Jubakuba/Keycult-TKL-Kicad/Support All PCBS.kicad_sch

## KiCad design Support All PCBS.kicad_sch (2026-08-12)

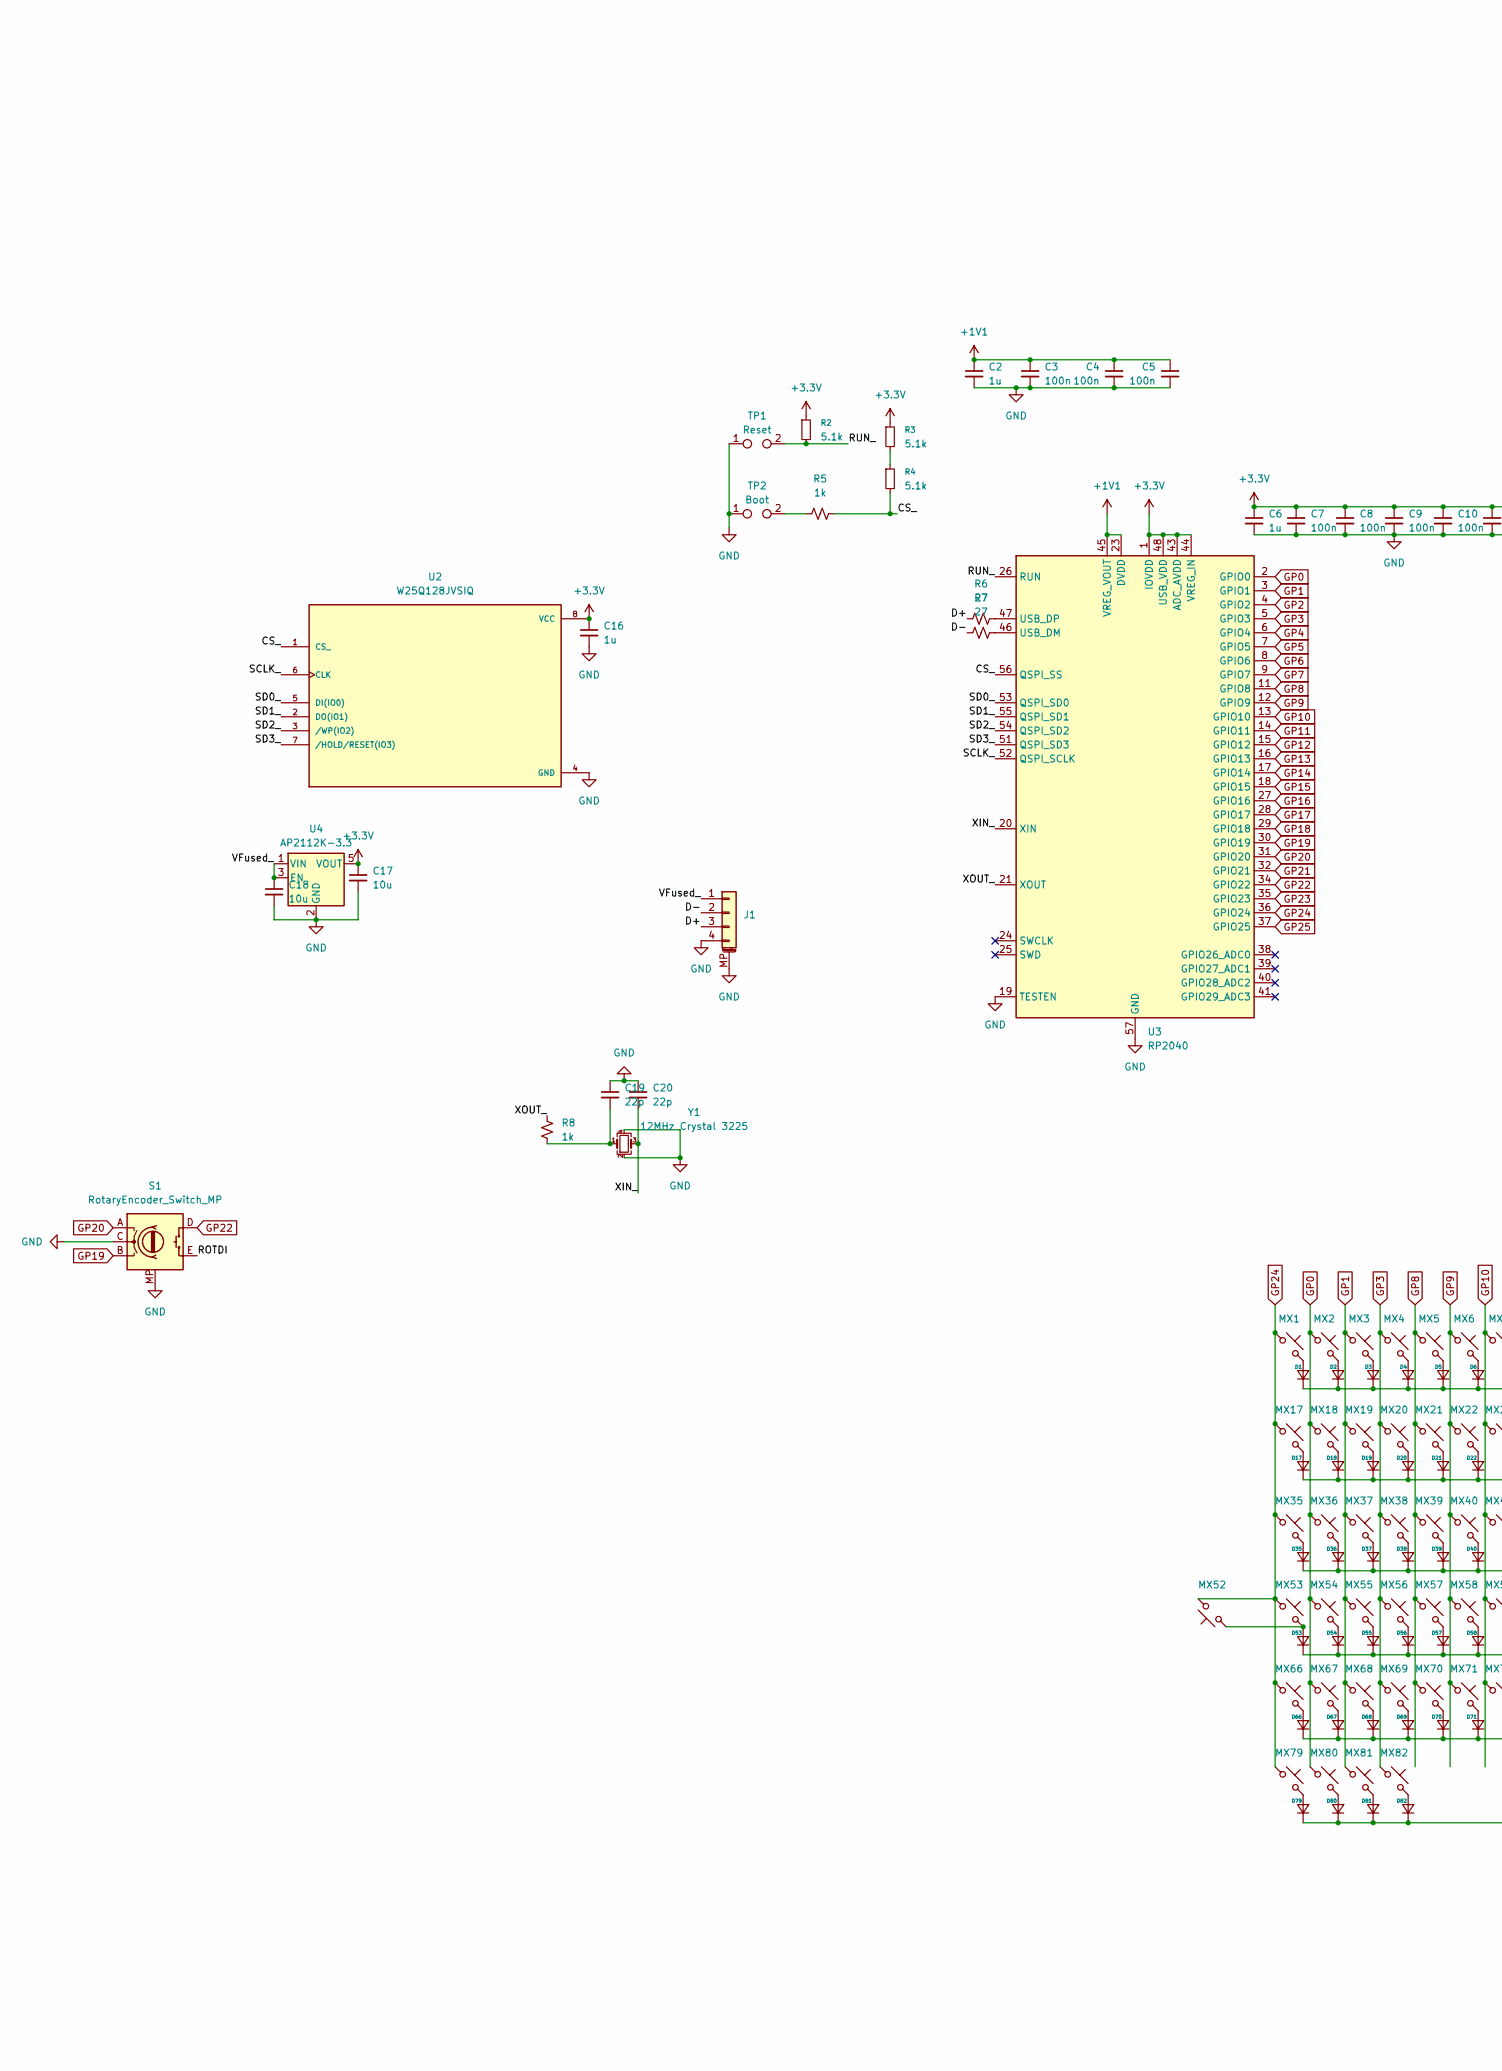
[picture p1: schematic Support All PCBS.kicad_sch, part in row 1, column 1]

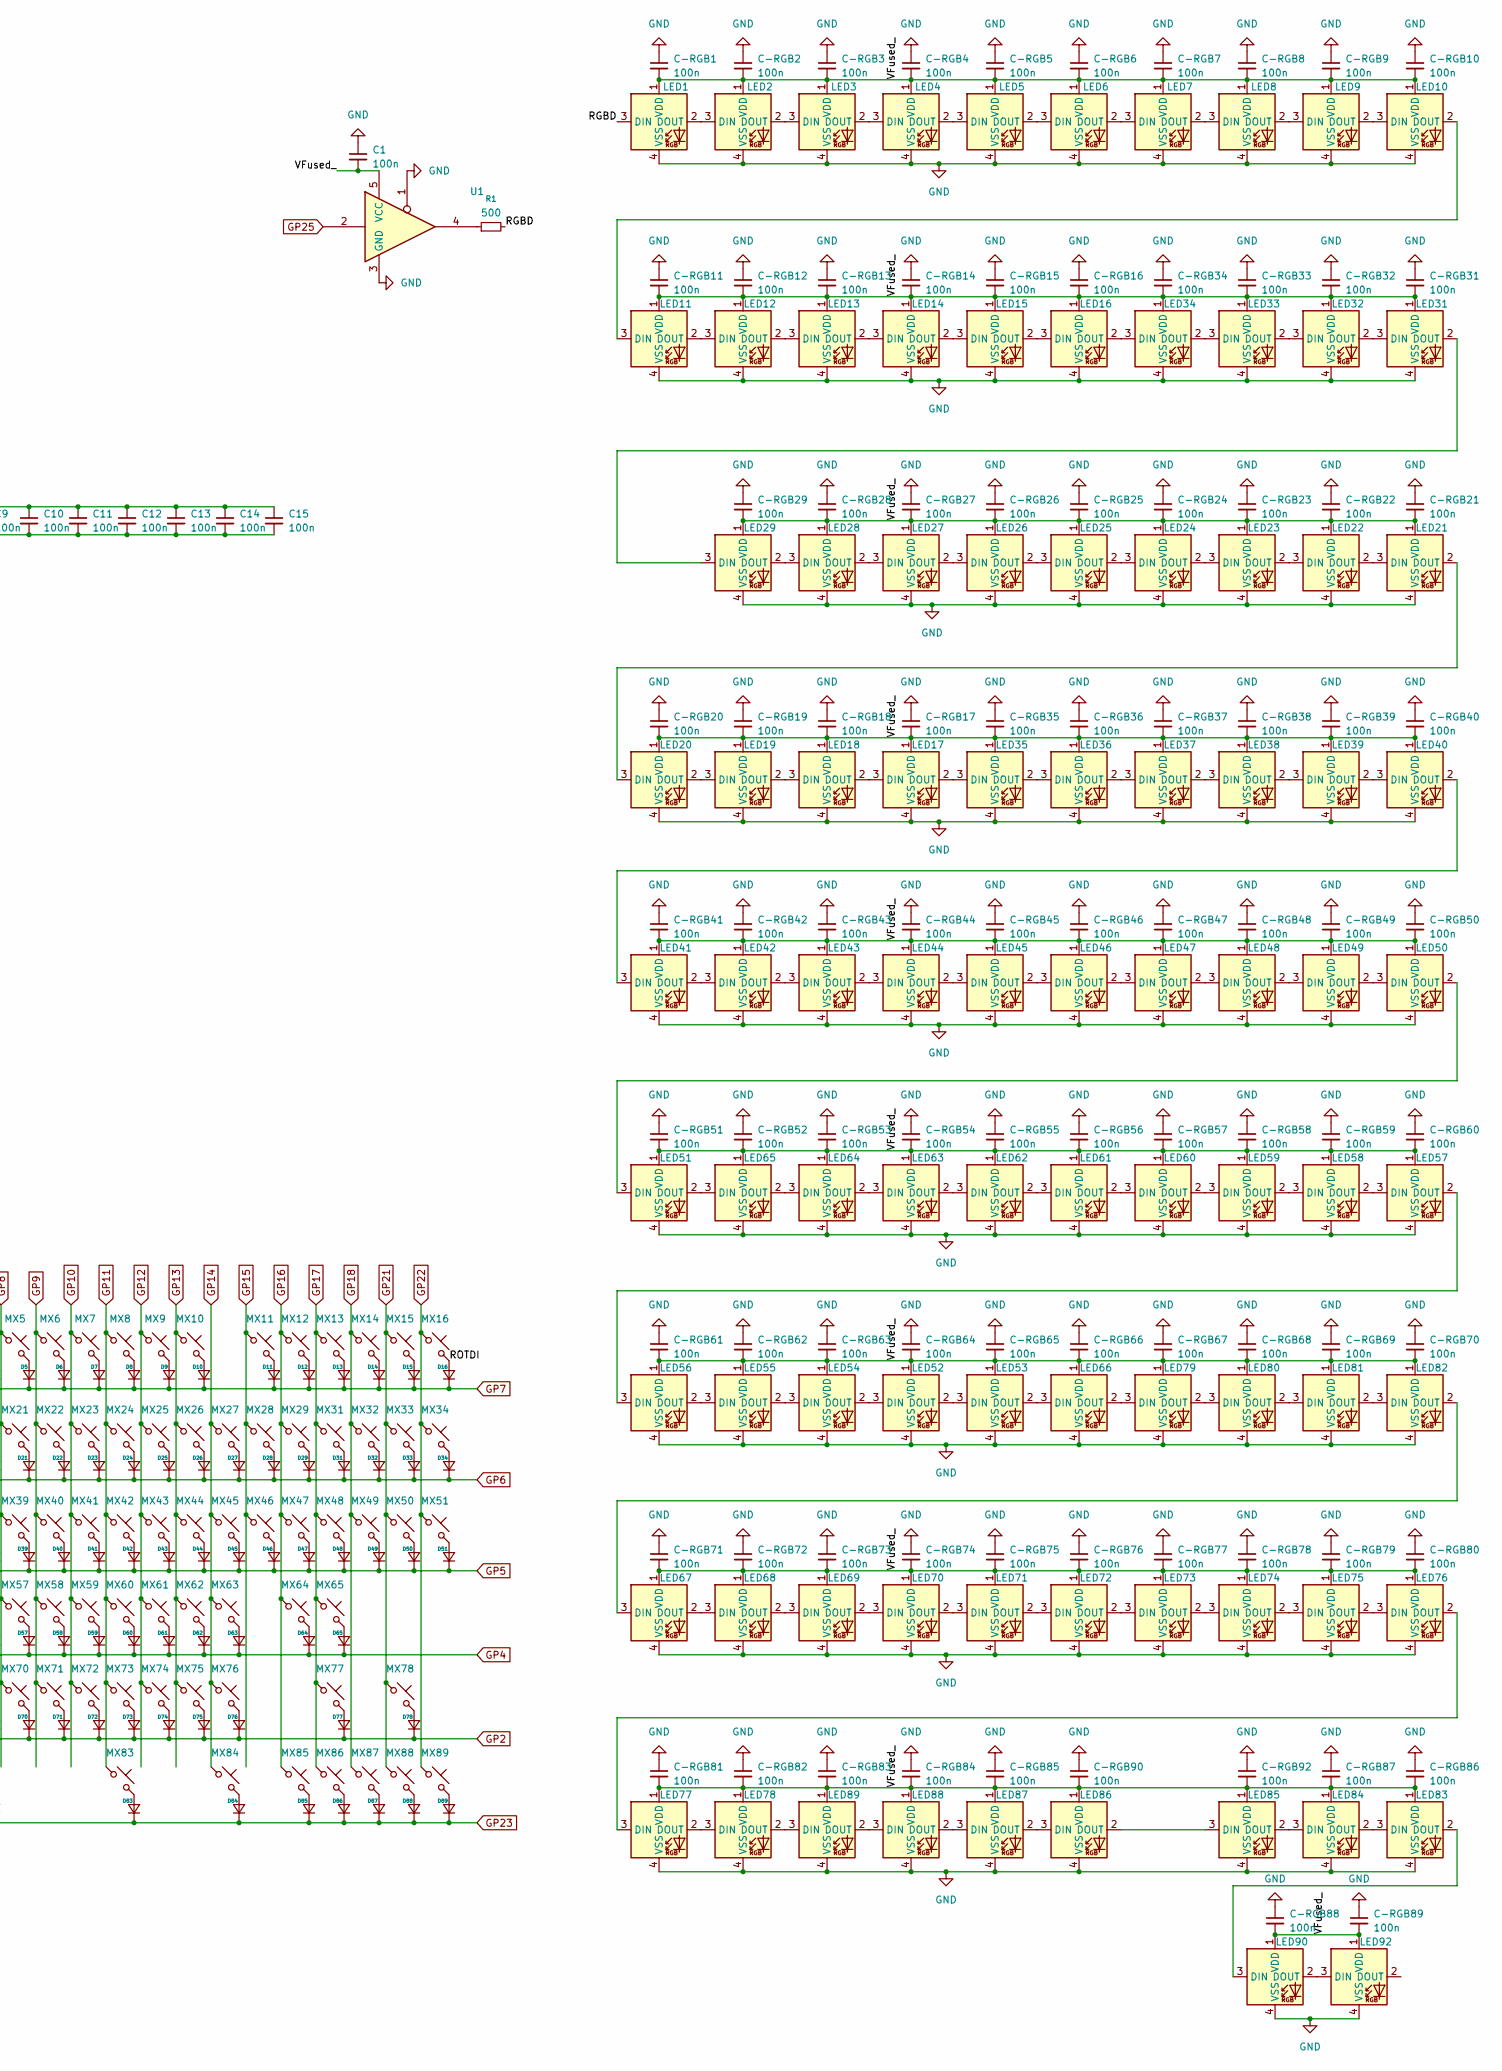
[picture p2: schematic Support All PCBS.kicad_sch, part in row 1, column 2]

Parts:
C1, C3, C4, C5, C7, C8, C9, C10, C11, C12, C13, C14, C15: 100n; C_0402_1005Metric; LCSC C1525
C2, C6, C16: 1u; C_0402_1005Metric; LCSC C52923
C17, C18: 10u; C_0402_1005Metric; LCSC C315248
C19, C20: 22p; C_0402_1005Metric; LCSC C190090
C-RGB1, C-RGB2, C-RGB3, C-RGB4, C-RGB5, C-RGB6, C-RGB7, C-RGB8, C-RGB9, C-RGB10, C-RGB11, C-RGB12, C-RGB13, C-RGB14, C-RGB15, C-RGB16, C-RGB17, C-RGB18, C-RGB19, C-RGB20, C-RGB21, C-RGB22, C-RGB23, C-RGB24, C-RGB25, C-RGB26, C-RGB27, C-RGB28, C-RGB29, C-RGB31, C-RGB32, C-RGB33, C-RGB34, C-RGB35, C-RGB36, C-RGB37, C-RGB38, C-RGB39, C-RGB40, C-RGB41, C-RGB42, C-RGB43, C-RGB44, C-RGB45, C-RGB46, C-RGB47, C-RGB48, C-RGB49, C-RGB50, C-RGB51, C-RGB52, C-RGB53, C-RGB54, C-RGB55, C-RGB56, C-RGB57, C-RGB58, C-RGB59, C-RGB60, C-RGB61, C-RGB62, C-RGB63, C-RGB64, C-RGB65, C-RGB66, C-RGB67, C-RGB68, C-RGB69, C-RGB70, C-RGB71, C-RGB72, C-RGB73, C-RGB74, C-RGB75, C-RGB76, C-RGB77, C-RGB78, C-RGB79, C-RGB80, C-RGB81, C-RGB82, C-RGB83, C-RGB84, C-RGB85, C-RGB86, C-RGB87, C-RGB88, C-RGB89, C-RGB90, C-RGB92: 100n; C_0402_1005Metric; LCSC C1525
D1, D2, D3, D4, D5, D6, D7, D8, D9, D10, D11, D12, D13, D14, D15, D16, D17, D18, D19, D20, D21, D22, D23, D24, D25, D26, D27, D28, D29, D31, D32, D33, D34, D35, D36, D37, D38, D39, D40, D41, D42, D43, D44, D45, D46, D47, D48, D49, D50, D51, D53, D54, D55, D56, D57, D58, D59, D60, D61, D62, D63, D64, D65, D66, D67, D68, D69, D70, D71, D72, D73, D74, D75, D76, D77, D78, D79, D80, D81, D82, D83, D84, D85, D86, D87, D88, D89: 1N4148W; D_SOD-123
J1: JST - 1.00mm 4 Pin; JST_SH_SM04B-SRSS-TB_1x04-1MP_P1.00mm_Horizontal; LCSC C160404
LED1, LED2, LED3, LED4, LED5, LED6, LED7, LED8, LED9, LED10, LED11, LED12, LED13, LED14, LED15, LED16, LED35, LED36, LED37, LED38, LED39, LED40, LED41, LED42, LED43, LED44, LED45, LED46, LED47, LED48, LED49, LED50, LED51, LED66, LED67, LED68, LED69, LED70, LED71, LED72, LED73, LED74, LED75, LED76, LED77, LED78, LED79, LED80, LED81, LED82: MX_SK6812MINI-E; LED_MX_6028R-ROT; LCSC C5149201
LED17, LED18, LED19, LED20, LED21, LED22, LED23, LED24, LED25, LED26, LED27, LED28, LED29, LED31, LED32, LED33, LED34, LED52, LED53, LED54, LED55, LED56, LED57, LED58, LED59, LED60, LED61, LED62, LED63, LED64, LED65, LED83, LED84, LED85, LED86, LED87, LED88, LED89, LED90, LED92: MX_SK6812MINI-E; LED_MX_6028R; LCSC C5149201
MX1, MX2, MX3, MX4, MX5, MX6, MX7, MX8, MX9, MX10, MX11, MX12, MX13, MX14, MX15, MX17, MX18, MX19, MX20, MX21, MX22, MX23, MX24, MX25, MX26, MX27, MX28, MX29, MX31, MX32, MX33, MX34, MX36, MX37, MX38, MX39, MX40, MX41, MX42, MX43, MX44, MX45, MX46, MX47, MX48, MX49, MX50, MX51, MX53, MX54, MX55, MX56, MX57, MX58, MX59, MX60, MX61, MX62, MX63, MX64, MX65, MX66, MX67, MX68, MX69, MX70, MX71, MX72, MX73, MX74, MX75, MX76, MX77, MX78, MX79, MX80, MX81, MX82, MX83, MX84, MX85, MX86, MX87, MX88, MX89: SW_MX_HS_CPG151101S11_1u; LCSC C49352235
MX16: SW_MX_HotSwap_THT; LCSC C49352235
MX35: SW_MX_HS_CPG151101S11_1.5u; LCSC C49352235
MX52: SW_MX_HS_CPG151101S11_1.75u_STP_1.25; LCSC C49352235
R1: 500; R_0402_1005Metric; LCSC C25117
R2, R3, R4: 5.1k; R_0402_1005Metric; LCSC C25905
R5, R8: 1k; R_0402_1005Metric; LCSC C106235
R6, R7: 27; R_0402_1005Metric; LCSC C22369246
S1: RotaryEncoder_Switch_MP; XDCR_EC11J1520402
TP1: Reset; R_0805_2012Metric
TP2: Boot; R_0805_2012Metric
U1: 74AHCT1G125; SOT-23-5; LCSC C7484
U2: W25Q128JVSIQ; SOIC-8_5.3x5.3mm_P1.27mm; PARTREV I; LCSC C97521
U3: RP2040; QFN-56-1EP_7x7mm_P0.4mm_EP3.2x3.2mm_ThermalVias; LCSC C2040
U4: AP2112K-3.3; SOT-23-5; LCSC C51118
Y1: 12MHz Crystal 3225; Crystal_SMD_3225-4Pin_3.2x2.5mm; LCSC C9002

Connections:
+1V1: C2.1, C3.1, C4.1, C5.1, U3.23 (DVDD), U3.45 (VREG_VOUT), U3.50 (DVDD)
+3.3V: C6.1, C7.1, C8.1, C9.1, C10.1, C11.1, C12.1, C13.1, C14.1, C15.1, C16.1, C17.1, R2.1, R3.1, U2.8 (VCC), U3.1 (IOVDD), U3.10 (IOVDD), U3.22 (IOVDD), U3.33 (IOVDD), U3.42 (IOVDD), U3.43 (ADC_AVDD), U3.44 (VREG_IN), U3.48 (USB_VDD), U3.49 (IOVDD), U4.5 (VOUT)
CS_: R4.2, R5.2, U2.1 (CS_), U3.56 (QSPI_SS)
D+: J1.3, R6.2
D-: J1.2, R7.1
GND: C1.1, C2.2, C3.2, C4.2, C5.2, C6.2, C7.2, C8.2, C9.2, C10.2, C11.2, C12.2, C13.2, C14.2, C15.2, C16.2, C17.2, C18.2, C19.1, C20.1, C-RGB1.1, C-RGB2.1, C-RGB3.1, C-RGB4.1, C-RGB5.1, C-RGB6.1, C-RGB7.1, C-RGB8.1, C-RGB9.1, C-RGB10.1, C-RGB11.1, C-RGB12.1, C-RGB13.1, C-RGB14.1, C-RGB15.1, C-RGB16.1, C-RGB17.1, C-RGB18.1, C-RGB19.1, C-RGB20.1, C-RGB21.1, C-RGB22.1, C-RGB23.1, C-RGB24.1, C-RGB25.1, C-RGB26.1, C-RGB27.1, C-RGB28.1, C-RGB29.1, C-RGB31.1, C-RGB32.1, C-RGB33.1, C-RGB34.1, C-RGB35.1, C-RGB36.1, C-RGB37.1, C-RGB38.1, C-RGB39.1, C-RGB40.1, C-RGB41.1, C-RGB42.1, C-RGB43.1, C-RGB44.1, C-RGB45.1, C-RGB46.1, C-RGB47.1, C-RGB48.1, C-RGB49.1, C-RGB50.1, C-RGB51.1, C-RGB52.1, C-RGB53.1, C-RGB54.1, C-RGB55.1, C-RGB56.1, C-RGB57.1, C-RGB58.1, C-RGB59.1, C-RGB60.1, C-RGB61.1, C-RGB62.1, C-RGB63.1, C-RGB64.1, C-RGB65.1, C-RGB66.1, C-RGB67.1, C-RGB68.1, C-RGB69.1, C-RGB70.1, C-RGB71.1, C-RGB72.1, C-RGB73.1, C-RGB74.1, C-RGB75.1, C-RGB76.1, C-RGB77.1, C-RGB78.1, C-RGB79.1, C-RGB80.1, C-RGB81.1, C-RGB82.1, C-RGB83.1, C-RGB84.1, C-RGB85.1, C-RGB86.1, C-RGB87.1, C-RGB88.1, C-RGB89.1, C-RGB90.1, C-RGB92.1, J1.4, J1.MP (MountPin), LED1.4 (VSS), LED2.4 (VSS), LED3.4 (VSS), LED4.4 (VSS), LED5.4 (VSS), LED6.4 (VSS), LED7.4 (VSS), LED8.4 (VSS), LED9.4 (VSS), LED10.4 (VSS), LED11.4 (VSS), LED12.4 (VSS), LED13.4 (VSS), LED14.4 (VSS), LED15.4 (VSS), LED16.4 (VSS), LED17.4 (VSS), LED18.4 (VSS), LED19.4 (VSS), LED20.4 (VSS), LED21.4 (VSS), LED22.4 (VSS), LED23.4 (VSS), LED24.4 (VSS), LED25.4 (VSS), LED26.4 (VSS), LED27.4 (VSS), LED28.4 (VSS), LED29.4 (VSS), LED31.4 (VSS), LED32.4 (VSS), LED33.4 (VSS), LED34.4 (VSS), LED35.4 (VSS), LED36.4 (VSS), LED37.4 (VSS), LED38.4 (VSS), LED39.4 (VSS), LED40.4 (VSS), LED41.4 (VSS), LED42.4 (VSS), LED43.4 (VSS), LED44.4 (VSS), LED45.4 (VSS), LED46.4 (VSS), LED47.4 (VSS), LED48.4 (VSS), LED49.4 (VSS), LED50.4 (VSS), LED51.4 (VSS), LED52.4 (VSS), LED53.4 (VSS), LED54.4 (VSS), LED55.4 (VSS), LED56.4 (VSS), LED57.4 (VSS), LED58.4 (VSS), LED59.4 (VSS), LED60.4 (VSS), LED61.4 (VSS), LED62.4 (VSS), LED63.4 (VSS), LED64.4 (VSS), LED65.4 (VSS), LED66.4 (VSS), LED67.4 (VSS), LED68.4 (VSS), LED69.4 (VSS), LED70.4 (VSS), LED71.4 (VSS), LED72.4 (VSS), LED73.4 (VSS), LED74.4 (VSS), LED75.4 (VSS), LED76.4 (VSS), LED77.4 (VSS), LED78.4 (VSS), LED79.4 (VSS), LED80.4 (VSS), LED81.4 (VSS), LED82.4 (VSS), LED83.4 (VSS), LED84.4 (VSS), LED85.4 (VSS), LED86.4 (VSS), LED87.4 (VSS), LED88.4 (VSS), LED89.4 (VSS), LED90.4 (VSS), LED92.4 (VSS), S1.C, S1.MP, TP1.1, TP2.1, U1.1, U1.3 (GND), U2.4 (GND), U3.19 (TESTEN), U3.57 (GND), U4.2 (GND), Y1.2, Y1.4
GP0: MX2.1, MX18.1, MX36.1, MX54.1, MX67.1, MX80.1, U3.2 (GPIO0)
GP1: MX3.1, MX19.1, MX37.1, MX55.1, MX68.1, MX81.1, U3.3 (GPIO1)
GP2: D66.1 (K), D67.1 (K), D68.1 (K), D69.1 (K), D70.1 (K), D71.1 (K), D72.1 (K), D73.1 (K), D74.1 (K), D75.1 (K), D76.1 (K), D77.1 (K), D78.1 (K), U3.4 (GPIO2)
GP3: MX4.1, MX20.1, MX38.1, MX56.1, MX69.1, MX82.1, U3.5 (GPIO3)
GP4: D53.1 (K), D54.1 (K), D55.1 (K), D56.1 (K), D57.1 (K), D58.1 (K), D59.1 (K), D60.1 (K), D61.1 (K), D62.1 (K), D63.1 (K), D64.1 (K), D65.1 (K), U3.6 (GPIO4)
GP5: D35.1 (K), D36.1 (K), D37.1 (K), D38.1 (K), D39.1 (K), D40.1 (K), D41.1 (K), D42.1 (K), D43.1 (K), D44.1 (K), D45.1 (K), D46.1 (K), D47.1 (K), D48.1 (K), D49.1 (K), D50.1 (K), D51.1 (K), U3.7 (GPIO5)
GP6: D17.1 (K), D18.1 (K), D19.1 (K), D20.1 (K), D21.1 (K), D22.1 (K), D23.1 (K), D24.1 (K), D25.1 (K), D26.1 (K), D27.1 (K), D28.1 (K), D29.1 (K), D31.1 (K), D32.1 (K), D33.1 (K), D34.1 (K), U3.8 (GPIO6)
GP7: D1.1 (K), D2.1 (K), D3.1 (K), D4.1 (K), D5.1 (K), D6.1 (K), D7.1 (K), D8.1 (K), D9.1 (K), D10.1 (K), D11.1 (K), D12.1 (K), D13.1 (K), D14.1 (K), D15.1 (K), D16.1 (K), U3.9 (GPIO7)
GP8: MX5.1, MX21.1, MX39.1, MX57.1, MX70.1, U3.11 (GPIO8)
GP9: MX6.1, MX22.1, MX40.1, MX58.1, MX71.1, U3.12 (GPIO9)
GP10: MX7.1, MX23.1, MX41.1, MX59.1, MX72.1, U3.13 (GPIO10)
GP11: MX8.1, MX24.1, MX42.1, MX60.1, MX73.1, MX83.1, U3.14 (GPIO11)
GP12: MX9.1, MX25.1, MX43.1, MX61.1, MX74.1, U3.15 (GPIO12)
GP13: MX10.1, MX26.1, MX44.1, MX62.1, MX75.1, U3.16 (GPIO13)
GP14: MX27.1, MX45.1, MX63.1, MX76.1, MX84.1, U3.17 (GPIO14)
GP15: MX11.1, MX28.1, MX46.1, U3.18 (GPIO15)
GP16: MX12.1, MX29.1, MX47.1, MX64.1, MX85.1, U3.27 (GPIO16)
GP17: MX13.1, MX31.1, MX48.1, MX65.1, MX77.1, MX86.1, U3.28 (GPIO17)
GP18: MX14.1, MX32.1, MX49.1, MX87.1, U3.29 (GPIO18)
GP19: S1.B, U3.30 (GPIO19)
GP20: S1.A, U3.31 (GPIO20)
GP21: MX15.1, MX33.1, MX50.1, MX78.1, MX88.1, U3.32 (GPIO21)
GP22: MX16.1, MX34.1, MX51.1, MX89.1, S1.D, U3.34 (GPIO22)
GP23: D79.1 (K), D80.1 (K), D81.1 (K), D82.1 (K), D83.1 (K), D84.1 (K), D85.1 (K), D86.1 (K), D87.1 (K), D88.1 (K), D89.1 (K), U3.35 (GPIO23)
GP24: MX1.1, MX17.1, MX35.1, MX52.2, MX53.1, MX66.1, MX79.1, U3.36 (GPIO24)
GP25: U1.2, U3.37 (GPIO25)
unnamed: C19.2, R8.1, Y1.1
unnamed: D1.2 (A), MX1.2
unnamed: D2.2 (A), MX2.2
unnamed: D3.2 (A), MX3.2
unnamed: D4.2 (A), MX4.2
unnamed: D5.2 (A), MX5.2
unnamed: D6.2 (A), MX6.2
unnamed: D7.2 (A), MX7.2
unnamed: D8.2 (A), MX8.2
unnamed: D9.2 (A), MX9.2
unnamed: D10.2 (A), MX10.2
unnamed: D11.2 (A), MX11.2
unnamed: D12.2 (A), MX12.2
unnamed: D13.2 (A), MX13.2
unnamed: D14.2 (A), MX14.2
unnamed: D15.2 (A), MX15.2
unnamed: D17.2 (A), MX17.2
unnamed: D18.2 (A), MX18.2
unnamed: D19.2 (A), MX19.2
unnamed: D20.2 (A), MX20.2
unnamed: D21.2 (A), MX21.2
unnamed: D22.2 (A), MX22.2
unnamed: D23.2 (A), MX23.2
unnamed: D24.2 (A), MX24.2
unnamed: D25.2 (A), MX25.2
unnamed: D26.2 (A), MX26.2
unnamed: D27.2 (A), MX27.2
unnamed: D28.2 (A), MX28.2
unnamed: D29.2 (A), MX29.2
unnamed: D31.2 (A), MX31.2
unnamed: D32.2 (A), MX32.2
unnamed: D33.2 (A), MX33.2
unnamed: D34.2 (A), MX34.2
unnamed: D35.2 (A), MX35.2
unnamed: D36.2 (A), MX36.2
unnamed: D37.2 (A), MX37.2
unnamed: D38.2 (A), MX38.2
unnamed: D39.2 (A), MX39.2
unnamed: D40.2 (A), MX40.2
unnamed: D41.2 (A), MX41.2
unnamed: D42.2 (A), MX42.2
unnamed: D43.2 (A), MX43.2
unnamed: D44.2 (A), MX44.2
unnamed: D45.2 (A), MX45.2
unnamed: D46.2 (A), MX46.2
unnamed: D47.2 (A), MX47.2
unnamed: D48.2 (A), MX48.2
unnamed: D49.2 (A), MX49.2
unnamed: D50.2 (A), MX50.2
unnamed: D51.2 (A), MX51.2
unnamed: D53.2 (A), MX52.1, MX53.2
unnamed: D54.2 (A), MX54.2
unnamed: D55.2 (A), MX55.2
unnamed: D56.2 (A), MX56.2
unnamed: D57.2 (A), MX57.2
unnamed: D58.2 (A), MX58.2
unnamed: D59.2 (A), MX59.2
unnamed: D60.2 (A), MX60.2
unnamed: D61.2 (A), MX61.2
unnamed: D62.2 (A), MX62.2
unnamed: D63.2 (A), MX63.2
unnamed: D64.2 (A), MX64.2
unnamed: D65.2 (A), MX65.2
unnamed: D66.2 (A), MX66.2
unnamed: D67.2 (A), MX67.2
unnamed: D68.2 (A), MX68.2
unnamed: D69.2 (A), MX69.2
unnamed: D70.2 (A), MX70.2
unnamed: D71.2 (A), MX71.2
unnamed: D72.2 (A), MX72.2
unnamed: D73.2 (A), MX73.2
unnamed: D74.2 (A), MX74.2
unnamed: D75.2 (A), MX75.2
unnamed: D76.2 (A), MX76.2
unnamed: D77.2 (A), MX77.2
unnamed: D78.2 (A), MX78.2
unnamed: D79.2 (A), MX79.2
unnamed: D80.2 (A), MX80.2
unnamed: D81.2 (A), MX81.2
unnamed: D82.2 (A), MX82.2
unnamed: D83.2 (A), MX83.2
unnamed: D84.2 (A), MX84.2
unnamed: D85.2 (A), MX85.2
unnamed: D86.2 (A), MX86.2
unnamed: D87.2 (A), MX87.2
unnamed: D88.2 (A), MX88.2
unnamed: D89.2 (A), MX89.2
unnamed: LED1.2 (DOUT), LED2.3 (DIN)
unnamed: LED2.2 (DOUT), LED3.3 (DIN)
unnamed: LED3.2 (DOUT), LED4.3 (DIN)
unnamed: LED4.2 (DOUT), LED5.3 (DIN)
unnamed: LED5.2 (DOUT), LED6.3 (DIN)
unnamed: LED6.2 (DOUT), LED7.3 (DIN)
unnamed: LED7.2 (DOUT), LED8.3 (DIN)
unnamed: LED8.2 (DOUT), LED9.3 (DIN)
unnamed: LED10.2 (DOUT), LED11.3 (DIN)
unnamed: LED9.2 (DOUT), LED10.3 (DIN)
unnamed: LED11.2 (DOUT), LED12.3 (DIN)
unnamed: LED12.2 (DOUT), LED13.3 (DIN)
unnamed: LED13.2 (DOUT), LED14.3 (DIN)
unnamed: LED14.2 (DOUT), LED15.3 (DIN)
unnamed: LED15.2 (DOUT), LED16.3 (DIN)
unnamed: LED16.2 (DOUT), LED34.3 (DIN)
unnamed: LED17.2 (DOUT), LED35.3 (DIN)
unnamed: LED17.3 (DIN), LED18.2 (DOUT)
unnamed: LED18.3 (DIN), LED19.2 (DOUT)
unnamed: LED19.3 (DIN), LED20.2 (DOUT)
unnamed: LED20.3 (DIN), LED21.2 (DOUT)
unnamed: LED21.3 (DIN), LED22.2 (DOUT)
unnamed: LED22.3 (DIN), LED23.2 (DOUT)
unnamed: LED23.3 (DIN), LED24.2 (DOUT)
unnamed: LED24.3 (DIN), LED25.2 (DOUT)
unnamed: LED25.3 (DIN), LED26.2 (DOUT)
unnamed: LED26.3 (DIN), LED27.2 (DOUT)
unnamed: LED27.3 (DIN), LED28.2 (DOUT)
unnamed: LED28.3 (DIN), LED29.2 (DOUT)
unnamed: LED29.3 (DIN), LED31.2 (DOUT)
unnamed: LED31.3 (DIN), LED32.2 (DOUT)
unnamed: LED32.3 (DIN), LED33.2 (DOUT)
unnamed: LED33.3 (DIN), LED34.2 (DOUT)
unnamed: LED35.2 (DOUT), LED36.3 (DIN)
unnamed: LED36.2 (DOUT), LED37.3 (DIN)
unnamed: LED37.2 (DOUT), LED38.3 (DIN)
unnamed: LED38.2 (DOUT), LED39.3 (DIN)
unnamed: LED39.2 (DOUT), LED40.3 (DIN)
unnamed: LED40.2 (DOUT), LED41.3 (DIN)
unnamed: LED41.2 (DOUT), LED42.3 (DIN)
unnamed: LED42.2 (DOUT), LED43.3 (DIN)
unnamed: LED43.2 (DOUT), LED44.3 (DIN)
unnamed: LED44.2 (DOUT), LED45.3 (DIN)
unnamed: LED45.2 (DOUT), LED46.3 (DIN)
unnamed: LED46.2 (DOUT), LED47.3 (DIN)
unnamed: LED47.2 (DOUT), LED48.3 (DIN)
unnamed: LED48.2 (DOUT), LED49.3 (DIN)
unnamed: LED49.2 (DOUT), LED50.3 (DIN)
unnamed: LED50.2 (DOUT), LED51.3 (DIN)
unnamed: LED51.2 (DOUT), LED65.3 (DIN)
unnamed: LED52.2 (DOUT), LED53.3 (DIN)
unnamed: LED52.3 (DIN), LED54.2 (DOUT)
unnamed: LED53.2 (DOUT), LED66.3 (DIN)
unnamed: LED54.3 (DIN), LED55.2 (DOUT)
unnamed: LED55.3 (DIN), LED56.2 (DOUT)
unnamed: LED56.3 (DIN), LED57.2 (DOUT)
unnamed: LED57.3 (DIN), LED58.2 (DOUT)
unnamed: LED58.3 (DIN), LED59.2 (DOUT)
unnamed: LED59.3 (DIN), LED60.2 (DOUT)
unnamed: LED60.3 (DIN), LED61.2 (DOUT)
unnamed: LED61.3 (DIN), LED62.2 (DOUT)
unnamed: LED62.3 (DIN), LED63.2 (DOUT)
unnamed: LED63.3 (DIN), LED64.2 (DOUT)
unnamed: LED64.3 (DIN), LED65.2 (DOUT)
unnamed: LED66.2 (DOUT), LED79.3 (DIN)
unnamed: LED67.2 (DOUT), LED68.3 (DIN)
unnamed: LED67.3 (DIN), LED82.2 (DOUT)
unnamed: LED68.2 (DOUT), LED69.3 (DIN)
unnamed: LED69.2 (DOUT), LED70.3 (DIN)
unnamed: LED70.2 (DOUT), LED71.3 (DIN)
unnamed: LED71.2 (DOUT), LED72.3 (DIN)
unnamed: LED72.2 (DOUT), LED73.3 (DIN)
unnamed: LED73.2 (DOUT), LED74.3 (DIN)
unnamed: LED74.2 (DOUT), LED75.3 (DIN)
unnamed: LED75.2 (DOUT), LED76.3 (DIN)
unnamed: LED76.2 (DOUT), LED77.3 (DIN)
unnamed: LED77.2 (DOUT), LED78.3 (DIN)
unnamed: LED78.2 (DOUT), LED89.3 (DIN)
unnamed: LED79.2 (DOUT), LED80.3 (DIN)
unnamed: LED80.2 (DOUT), LED81.3 (DIN)
unnamed: LED81.2 (DOUT), LED82.3 (DIN)
unnamed: LED83.2 (DOUT), LED90.3 (DIN)
unnamed: LED83.3 (DIN), LED84.2 (DOUT)
unnamed: LED84.3 (DIN), LED85.2 (DOUT)
unnamed: LED85.3 (DIN), LED86.2 (DOUT)
unnamed: LED86.3 (DIN), LED87.2 (DOUT)
unnamed: LED87.3 (DIN), LED88.2 (DOUT)
unnamed: LED88.3 (DIN), LED89.2 (DOUT)
unnamed: LED90.2 (DOUT), LED92.3 (DIN)
unnamed: R1.1, U1.4
unnamed: R3.2, R4.1
unnamed: R5.1, TP2.2
unnamed: R6.1, U3.47 (USB_DP)
unnamed: R7.2, U3.46 (USB_DM)
RGBD: LED1.3 (DIN), R1.2
ROTDI: D16.2 (A), MX16.2, S1.E
RUN_: R2.2, TP1.2, U3.26 (RUN)
SCLK_: U2.6 (CLK), U3.52 (QSPI_SCLK)
SD0_: U2.5 (DI(IO0)), U3.53 (QSPI_SD0)
SD1_: U2.2 (DO(IO1)), U3.55 (QSPI_SD1)
SD2_: U2.3 (/WP(IO2)), U3.54 (QSPI_SD2)
SD3_: U2.7 (/HOLD/RESET(IO3)), U3.51 (QSPI_SD3)
VFused_: C1.2, C18.1, C-RGB1.2, C-RGB2.2, C-RGB3.2, C-RGB4.2, C-RGB5.2, C-RGB6.2, C-RGB7.2, C-RGB8.2, C-RGB9.2, C-RGB10.2, C-RGB11.2, C-RGB12.2, C-RGB13.2, C-RGB14.2, C-RGB15.2, C-RGB16.2, C-RGB17.2, C-RGB18.2, C-RGB19.2, C-RGB20.2, C-RGB21.2, C-RGB22.2, C-RGB23.2, C-RGB24.2, C-RGB25.2, C-RGB26.2, C-RGB27.2, C-RGB28.2, C-RGB29.2, C-RGB31.2, C-RGB32.2, C-RGB33.2, C-RGB34.2, C-RGB35.2, C-RGB36.2, C-RGB37.2, C-RGB38.2, C-RGB39.2, C-RGB40.2, C-RGB41.2, C-RGB42.2, C-RGB43.2, C-RGB44.2, C-RGB45.2, C-RGB46.2, C-RGB47.2, C-RGB48.2, C-RGB49.2, C-RGB50.2, C-RGB51.2, C-RGB52.2, C-RGB53.2, C-RGB54.2, C-RGB55.2, C-RGB56.2, C-RGB57.2, C-RGB58.2, C-RGB59.2, C-RGB60.2, C-RGB61.2, C-RGB62.2, C-RGB63.2, C-RGB64.2, C-RGB65.2, C-RGB66.2, C-RGB67.2, C-RGB68.2, C-RGB69.2, C-RGB70.2, C-RGB71.2, C-RGB72.2, C-RGB73.2, C-RGB74.2, C-RGB75.2, C-RGB76.2, C-RGB77.2, C-RGB78.2, C-RGB79.2, C-RGB80.2, C-RGB81.2, C-RGB82.2, C-RGB83.2, C-RGB84.2, C-RGB85.2, C-RGB86.2, C-RGB87.2, C-RGB88.2, C-RGB89.2, C-RGB90.2, C-RGB92.2, J1.1, LED1.1 (VDD), LED2.1 (VDD), LED3.1 (VDD), LED4.1 (VDD), LED5.1 (VDD), LED6.1 (VDD), LED7.1 (VDD), LED8.1 (VDD), LED9.1 (VDD), LED10.1 (VDD), LED11.1 (VDD), LED12.1 (VDD), LED13.1 (VDD), LED14.1 (VDD), LED15.1 (VDD), LED16.1 (VDD), LED17.1 (VDD), LED18.1 (VDD), LED19.1 (VDD), LED20.1 (VDD), LED21.1 (VDD), LED22.1 (VDD), LED23.1 (VDD), LED24.1 (VDD), LED25.1 (VDD), LED26.1 (VDD), LED27.1 (VDD), LED28.1 (VDD), LED29.1 (VDD), LED31.1 (VDD), LED32.1 (VDD), LED33.1 (VDD), LED34.1 (VDD), LED35.1 (VDD), LED36.1 (VDD), LED37.1 (VDD), LED38.1 (VDD), LED39.1 (VDD), LED40.1 (VDD), LED41.1 (VDD), LED42.1 (VDD), LED43.1 (VDD), LED44.1 (VDD), LED45.1 (VDD), LED46.1 (VDD), LED47.1 (VDD), LED48.1 (VDD), LED49.1 (VDD), LED50.1 (VDD), LED51.1 (VDD), LED52.1 (VDD), LED53.1 (VDD), LED54.1 (VDD), LED55.1 (VDD), LED56.1 (VDD), LED57.1 (VDD), LED58.1 (VDD), LED59.1 (VDD), LED60.1 (VDD), LED61.1 (VDD), LED62.1 (VDD), LED63.1 (VDD), LED64.1 (VDD), LED65.1 (VDD), LED66.1 (VDD), LED67.1 (VDD), LED68.1 (VDD), LED69.1 (VDD), LED70.1 (VDD), LED71.1 (VDD), LED72.1 (VDD), LED73.1 (VDD), LED74.1 (VDD), LED75.1 (VDD), LED76.1 (VDD), LED77.1 (VDD), LED78.1 (VDD), LED79.1 (VDD), LED80.1 (VDD), LED81.1 (VDD), LED82.1 (VDD), LED83.1 (VDD), LED84.1 (VDD), LED85.1 (VDD), LED86.1 (VDD), LED87.1 (VDD), LED88.1 (VDD), LED89.1 (VDD), LED90.1 (VDD), LED92.1 (VDD), U1.5 (VCC), U4.1 (VIN), U4.3 (EN)
XIN_: C20.2, U3.20 (XIN), Y1.3
XOUT_: R8.2, U3.21 (XOUT)
