Jubakuba/Keycult-TKL-Kicad/(commit log)

2026-08-04 Center Board Outline - Update BOM to not include Boot/Reset caps
    [TEST.kicad_sch]
2026-08-08 ...add mounting holes for v2...oops.
    [TKL3v2order_bom.csv, TKL3v2order_designators.csv, TKL3v2order_positions.csv]
2026-08-08 ...reexclude reset boot bom
2026-08-10 Build V2 With Mounting Holes && All Fixes Release-Ready Assuming Fitment
    [TEST.kicad_sch, TKL3v1order_bom.csv, TKL3v1order_designators.csv, TKL3v1order_positions.csv, TKL3v2order_bom.csv, TKL_bom.csv, TKL_designators.csv, TKL_positions.csv]
2026-08-10 ...turns out I took the edgecuts from a source that didn't realize a screw came after f10 not f9...
2026-08-11 rotate ECLLJ footprint to not press on LED
    [TEST.kicad_sch, TKL3v2order_positions.csv]
2026-08-12 Purchased PCB Paramaters
    [TEST.kicad_sch]
2026-08-19 Final Revision for a bit. Update Readme. Confirmed by building with TKL 1. TKL 2/3 unconfirmed still. This PCB SHOULD support all three.
    [Support All PCBS.kicad_sch, TEST.kicad_sch, TKL3v2order_bom.csv, TKL3v2order_designators.csv, TKL3v2order_positions.csv, TKL3v3order_bom.csv, TKL3v3order_designators.csv, TKL3v3order_positions.csv]
